Aleblazer/flatbox/hardware-RGB-OLED-Mod/3D Printed Case/Flatbox-RGB-OLED-Top.stl

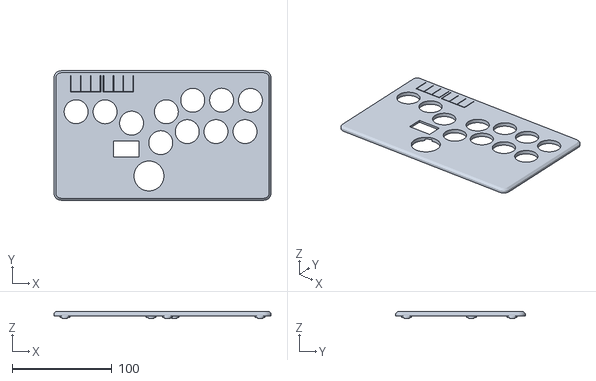
[picture p1: CAD file, 2022-11-18]
hardware-RGB-OLED-Mod/3D Printed Case/Flatbox-RGB-OLED-Top.stl
218.0 x 130.1 x 7.20
