Aleblazer/flatbox/hardware-RGB-OLED-Mod/Flatbox-RGB-OLED.step

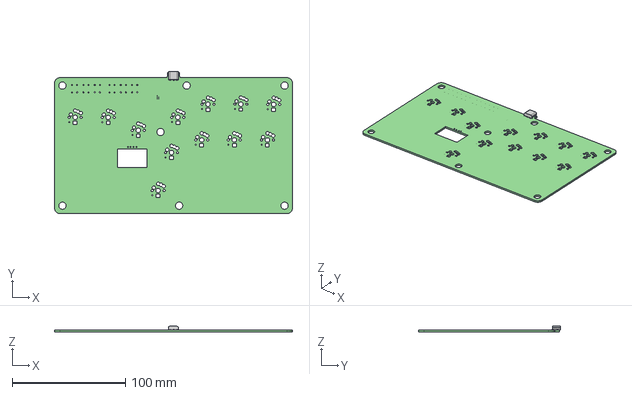
[picture p2: CAD file, 2022-11-07]
hardware-RGB-OLED-Mod/Flatbox-RGB-OLED.step
210.0 x 125.5 x 4.86 mm
_autosave-Flatbox-rev4 PCB
