Aleblazer/flatbox/hardware-RGB-OLED-Mod/3D Printed Case/ButtoncapBig.stl

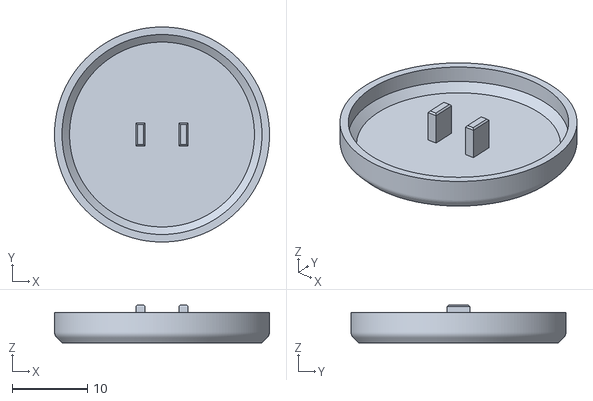
[picture p3: CAD file, 2022-11-07]
hardware-RGB-OLED-Mod/3D Printed Case/ButtoncapBig.stl
28.5 x 28.5 x 5.00
