Aleblazer/flatbox/hardware-RGB-OLED-Mod/3D Printed Case/Flatbox-RGB-OLED-Bottom.stl

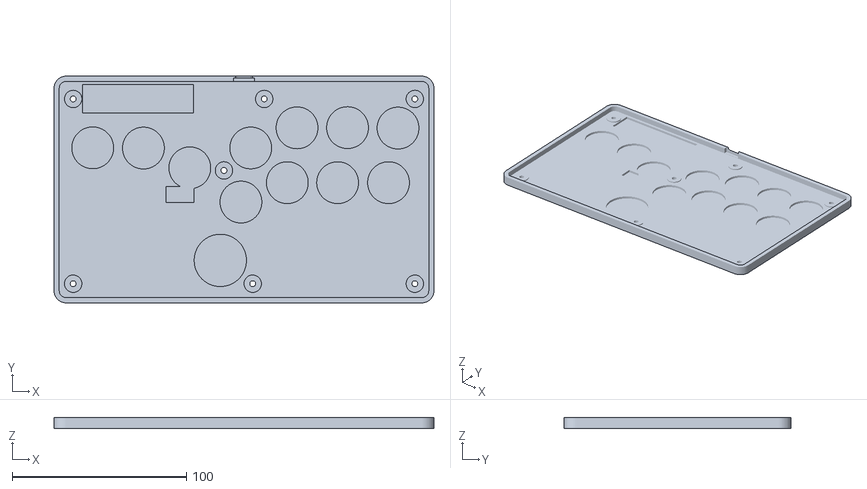
[picture p4: CAD file, 2022-11-07]
hardware-RGB-OLED-Mod/3D Printed Case/Flatbox-RGB-OLED-Bottom.stl
218.0 x 130.1 x 6.20
