Aleblazer/flatbox/hardware-RGB-OLED-Mod/3D Printed Case/Buttoncap.stl

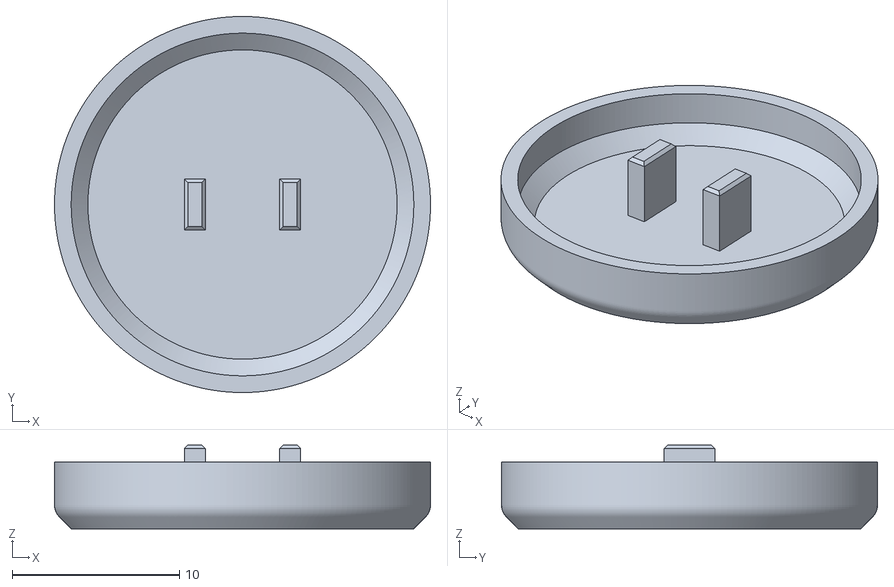
[picture p5: CAD file, 2022-11-07]
hardware-RGB-OLED-Mod/3D Printed Case/Buttoncap.stl
22.5 x 22.5 x 5.00
