Aleblazer/flatbox/hardware-RGB-OLED-Mod/Flatbox-rev4.kicad_pcb

## KiCad design hardware-RGB-OLED-Mod/Flatbox-rev4.kicad_pcb (2022-11-07)

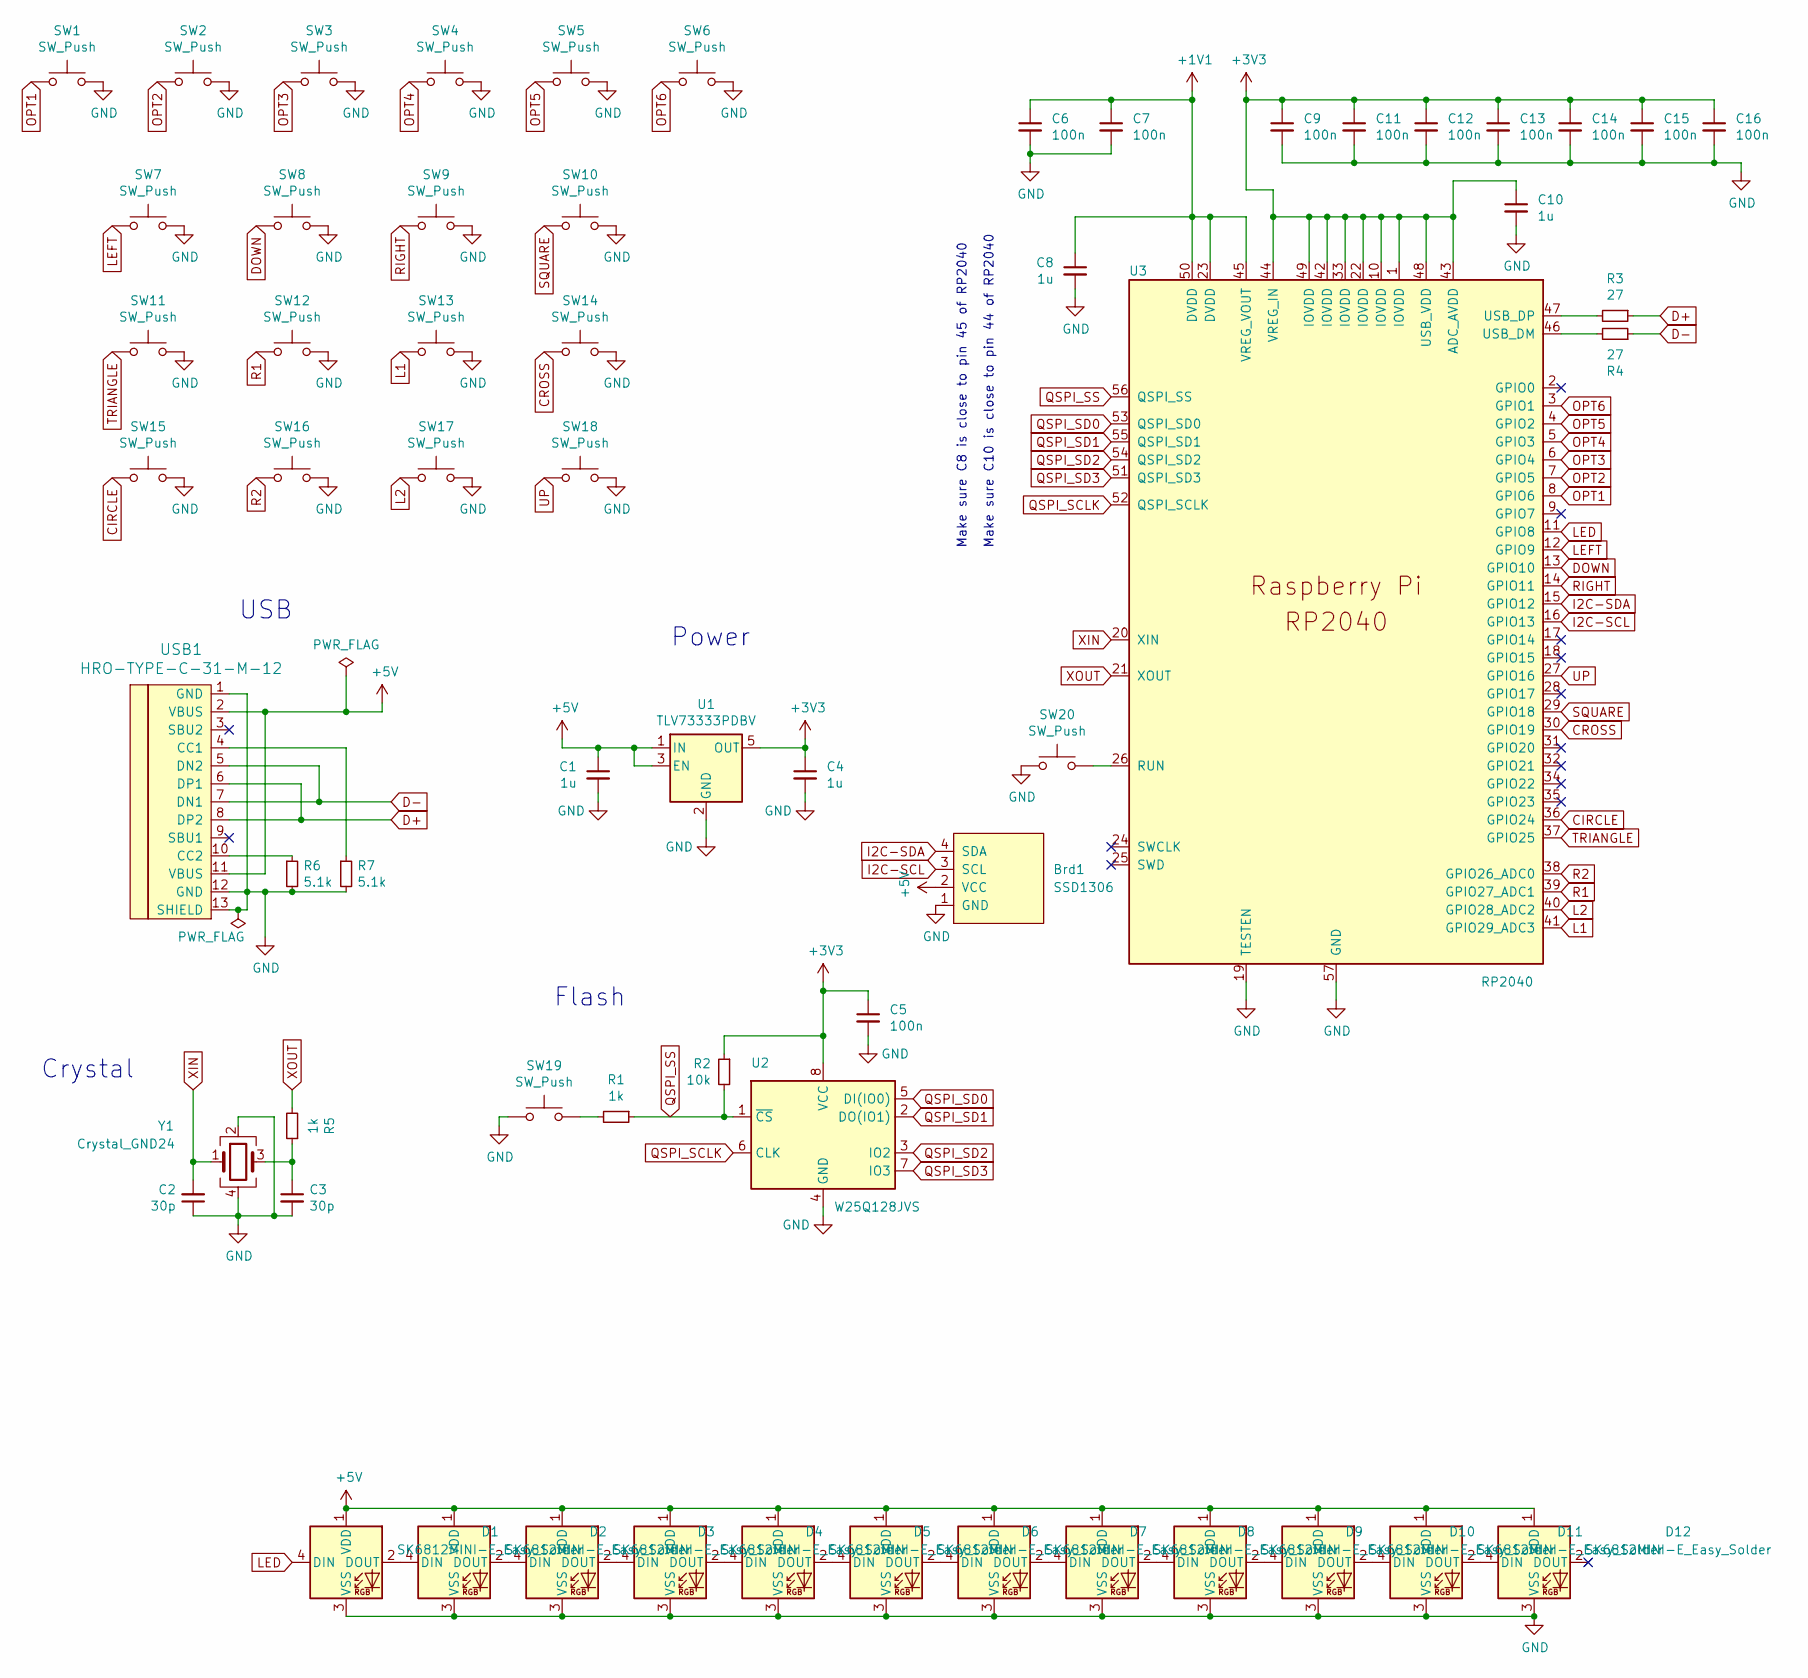
[picture p6: schematic Flatbox-rev4.kicad_sch]

Parts:
Brd1: SSD1306; 128x64OLED
C1, C4, C8, C10: 1u; C_0402_1005Metric; LCSC C52923
C2, C3: 30p; C_0402_1005Metric; LCSC C1570
C5, C6, C7, C9, C11, C12, C13, C14, C15, C16: 100n; C_0402_1005Metric; LCSC C1525
D1, D2, D3, D4, D5, D6, D7, D8, D9, D10, D11, D12: SK6812MINI-E_Easy_Solder; YS-SK6812MINI-E-SingleSide
R1, R5: 1k; R_0402_1005Metric; LCSC C11702
R2: 10k; R_0402_1005Metric; LCSC C25744
R3, R4: 27; R_0402_1005Metric; LCSC C138021
R6, R7: 5.1k; R_0402_1005Metric; LCSC C25905
SW1, SW2, SW3, SW4, SW5, SW6: SW_Push; SW_PUSH_6mm_H5mm
SW7, SW8, SW9, SW10, SW11, SW12, SW13, SW14, SW15, SW16, SW17, SW18: SW_Push; Kailh_socket_MX-ChocV1
SW19, SW20: SW_Push; SW_SPST_Omron_B3FS-100xP; LCSC C271750
U1: TLV73333PDBV; SOT-23-5; LCSC C134139
U2: W25Q128JVS; SOIC-8_5.23x5.23mm_P1.27mm; LCSC C97521
U3: RP2040; RP2040-QFN-56; LCSC C2040
USB1: HRO-TYPE-C-31-M-12; HRO-TYPE-C-31-M-12-Assembly; LCSC C165948
Y1: Crystal_GND24; Crystal_SMD_3225-4Pin_3.2x2.5mm; LCSC C9002

Connections:
+1V1: C6.1, C7.1, C8.1, U3.23 (DVDD), U3.45 (VREG_VOUT), U3.50 (DVDD)
+3V3: C4.1, C5.1, C9.1, C10.1, C11.1, C12.1, C13.1, C14.1, C15.1, C16.1, R2.1, U1.5 (OUT), U2.8 (VCC), U3.1 (IOVDD), U3.10 (IOVDD), U3.22 (IOVDD), U3.33 (IOVDD), U3.42 (IOVDD), U3.43 (ADC_AVDD), U3.44 (VREG_IN), U3.48 (USB_VDD), U3.49 (IOVDD)
+5V: Brd1.2 (VCC), C1.1, D1.1 (VDD), D2.1 (VDD), D3.1 (VDD), D4.1 (VDD), D5.1 (VDD), D6.1 (VDD), D7.1 (VDD), D8.1 (VDD), D9.1 (VDD), D10.1 (VDD), D11.1 (VDD), D12.1 (VDD), U1.1 (IN), U1.3 (EN), USB1.2 (VBUS), USB1.11 (VBUS); also elsewhere on the board
CIRCLE: SW15.1, U3.36 (GPIO24)
CROSS: SW14.1, U3.30 (GPIO19)
D+: R3.1, USB1.6 (DP1), USB1.8 (DP2)
D-: R4.1, USB1.5 (DN2), USB1.7 (DN1)
DOWN: SW8.1, U3.13 (GPIO10)
GND: Brd1.1 (GND), C1.2, C2.1, C3.2, C4.2, C5.2, C6.2, C7.2, C8.2, C9.2, C10.2, C11.2, C12.2, C13.2, C14.2, C15.2, C16.2, D1.3 (VSS), D2.3 (VSS), D3.3 (VSS), D4.3 (VSS), D5.3 (VSS), D6.3 (VSS), D7.3 (VSS), D8.3 (VSS), D9.3 (VSS), D10.3 (VSS), D11.3 (VSS), D12.3 (VSS), R6.2, R7.2, SW1.2, SW2.2, SW3.2, SW4.2, SW5.2, SW6.2, SW7.2, SW8.2, SW9.2, SW10.2, SW11.2, SW12.2, SW13.2, SW14.2, SW15.2, SW16.2, SW17.2, SW18.2, SW19.1, SW20.1, U1.2 (GND), U2.4 (GND), U3.19 (TESTEN), U3.57 (GND), USB1.1 (GND), USB1.12 (GND), USB1.13 (SHIELD), Y1.2, Y1.4; also elsewhere on the board
I2C-SCL: Brd1.3 (SCL), U3.16 (GPIO13); also elsewhere on the board
I2C-SDA: Brd1.4 (SDA), U3.15 (GPIO12); also elsewhere on the board
L1: SW13.1, U3.41 (GPIO29_ADC3)
L2: SW17.1, U3.40 (GPIO28_ADC2)
LED: D1.4 (DIN), U3.11 (GPIO8)
LEFT: SW7.1, U3.12 (GPIO9)
unnamed: C3.1, R5.1, Y1.3
unnamed: D1.2 (DOUT), D2.4 (DIN)
unnamed: D2.2 (DOUT), D3.4 (DIN)
unnamed: D3.2 (DOUT), D4.4 (DIN)
unnamed: D4.2 (DOUT), D5.4 (DIN)
unnamed: D5.2 (DOUT), D6.4 (DIN)
unnamed: D6.2 (DOUT), D7.4 (DIN)
unnamed: D7.2 (DOUT), D8.4 (DIN)
unnamed: D8.2 (DOUT), D9.4 (DIN)
unnamed: D10.2 (DOUT), D11.4 (DIN)
unnamed: D9.2 (DOUT), D10.4 (DIN)
unnamed: D11.2 (DOUT), D12.4 (DIN)
unnamed: R1.2, SW19.2
unnamed: R3.2, U3.47 (USB_DP)
unnamed: R4.2, U3.46 (USB_DM)
unnamed: R6.1, USB1.10 (CC2)
unnamed: R7.1, USB1.4 (CC1)
unnamed: SW20.2, U3.26 (RUN)
OPT1: SW1.1, U3.8 (GPIO6)
OPT2: SW2.1, U3.7 (GPIO5)
OPT3: SW3.1, U3.6 (GPIO4)
OPT4: SW4.1, U3.5 (GPIO3)
OPT5: SW5.1, U3.4 (GPIO2)
OPT6: SW6.1, U3.3 (GPIO1)
QSPI_SCLK: U2.6 (CLK), U3.52 (QSPI_SCLK)
QSPI_SD0: U2.5 (DI(IO0)), U3.53 (QSPI_SD0)
QSPI_SD1: U2.2 (DO(IO1)), U3.55 (QSPI_SD1)
QSPI_SD2: U2.3 (IO2), U3.54 (QSPI_SD2)
QSPI_SD3: U2.7 (IO3), U3.51 (QSPI_SD3)
QSPI_SS: R1.1, R2.2, U2.1 (~CS), U3.56 (QSPI_SS)
R1: SW12.1, U3.39 (GPIO27_ADC1)
R2: SW16.1, U3.38 (GPIO26_ADC0)
RIGHT: SW9.1, U3.14 (GPIO11)
SQUARE: SW10.1, U3.29 (GPIO18)
TRIANGLE: SW11.1, U3.37 (GPIO25)
UP: SW18.1, U3.27 (GPIO16)
XIN: C2.2, U3.20 (XIN), Y1.1
XOUT: R5.2, U3.21 (XOUT)

Notes on the sheet:
USB
Crystal
Make sure C8 is close to pin 45 of RP2040
Flash
Make sure C10 is close to pin 44 of RP2040
Power

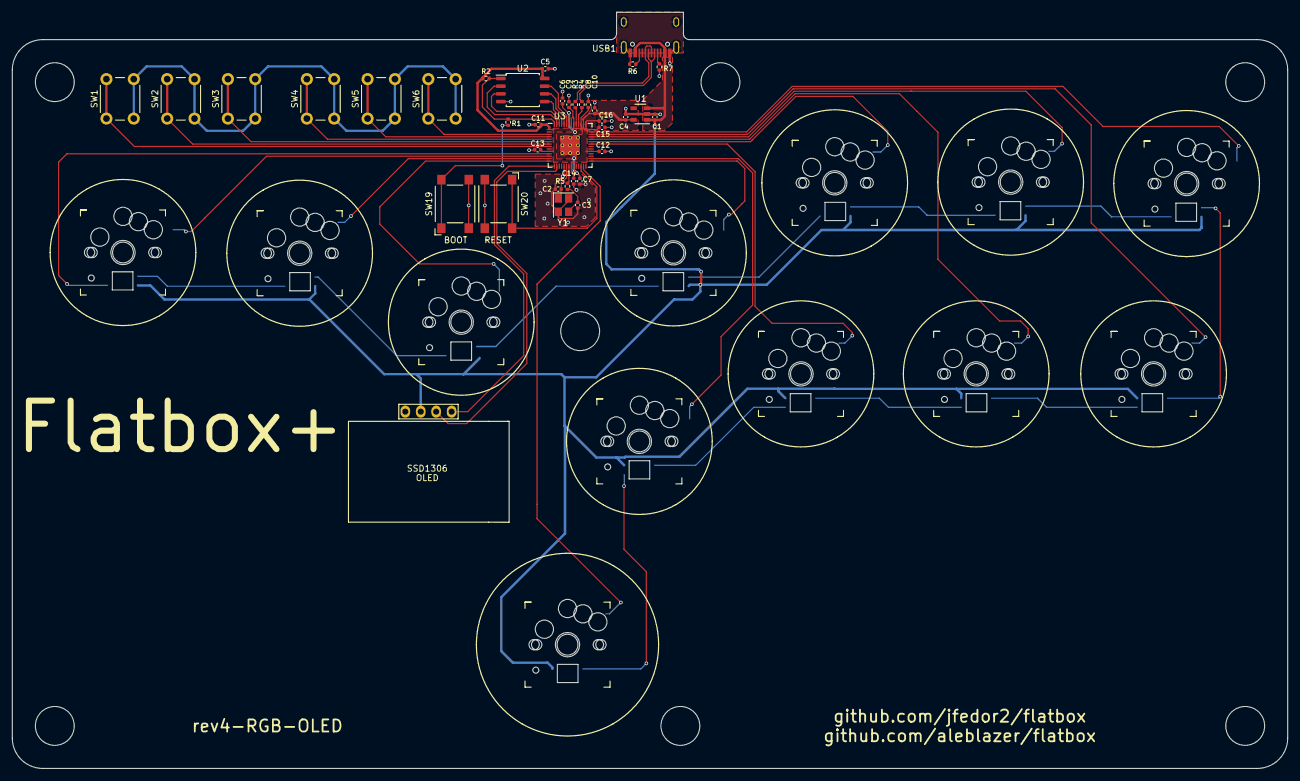
[picture p7: board Flatbox-rev4.kicad_pcb from above]

Board: 2 copper layers, 210.0 x 124.5 mm, 61 parts (0 on the bottom side), 53 nets.

Other parts of the board:
OLED: SSD1306; 128x64OLED

Their connections:
+5V: OLED.2 (VCC); also elsewhere on the board
GND: OLED.1 (GND); also elsewhere on the board
I2C-SCL: OLED.3 (SCL); also elsewhere on the board
I2C-SDA: OLED.4 (SDA); also elsewhere on the board
