Aleblazer/flatbox/(commit log)

2022-11-07 Added hardware-RGB-OLED-Mod
    Added folder and Kicad files for an updated version with combo MX/Choc hotswap footprints, Per key RGB and an OLED.
    [Flatbox-rev4.kicad_pcb, Flatbox-rev4.kicad_sch, Flatbox-rev4.sch]
2022-11-07 Added Gerber files
    Added Gerber files for production, PCBs on order from JLCPCB to confirm functionality.
    [Flatbox-rev4-B_Cu.gbl, Flatbox-rev4-B_Mask.gbs, Flatbox-rev4-B_Paste.gbp, Flatbox-rev4-B_Silkscreen.gbo, Flatbox-rev4-Edge_Cuts.gm1, Flatbox-rev4-F_Cu.gtl, Flatbox-rev4-F_Mask.gts, Flatbox-rev4-F_Paste.gtp]
2022-11-07 Added Case files
    Added modified case STLs
    [Buttoncap.stl, ButtoncapBig.stl, Flatbox-RGB-OLED-Bottom.stl, Flatbox-RGB-OLED-Top.stl, Flatbox-RGB-OLED.step]
2022-11-18 Updated Top Case for OLED
    Shifted OLED window down 1.5mm
    [Flatbox-RGB-OLED-Top.stl]
